Loopback59/Convector-Fan-Controller/AutoFan V4 PIC16f18424.pdf

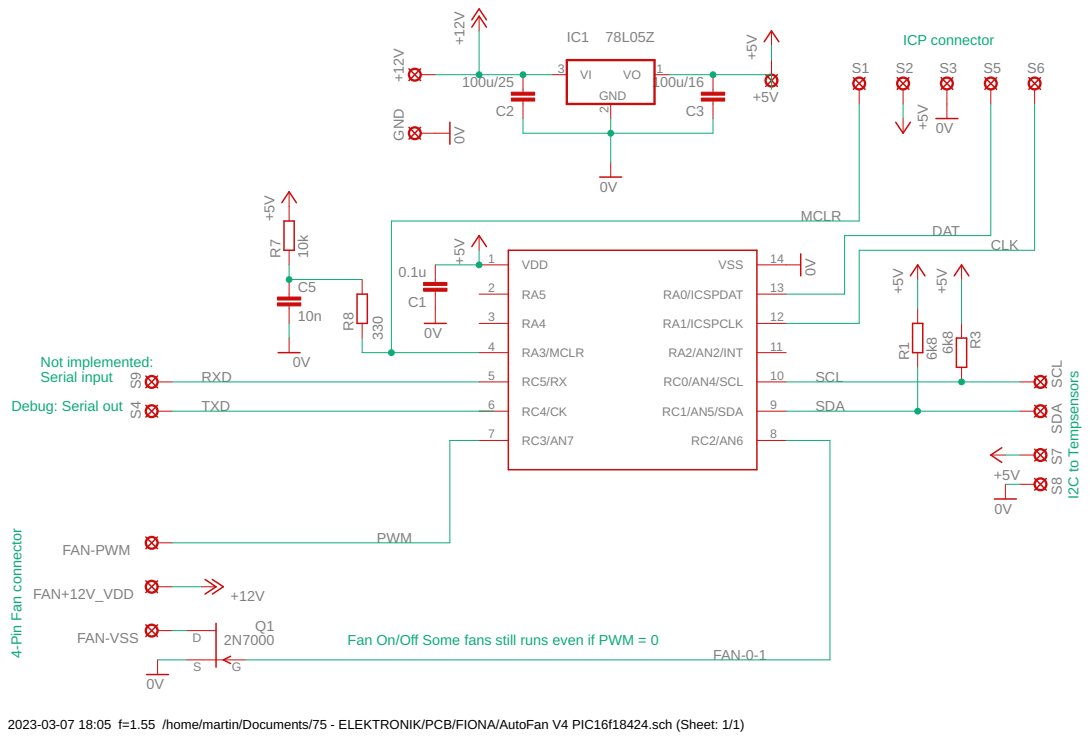
[picture p1: page 1]

Fan On/Off Some fans still runs even if PWM = 0

2023-03-07 18:05 f=1.55 /home/martin/Documents/75 - ELEKTRONIK/PCB/FIONA/AutoFan V4 PIC16f18424.sch (Sheet: 1/1)
