Loopback59/Convector-Fan-Controller/AutoFan V4 PIC16f18424.sch

## EAGLE design AutoFan V4 PIC16f18424.sch (2023-03-07)

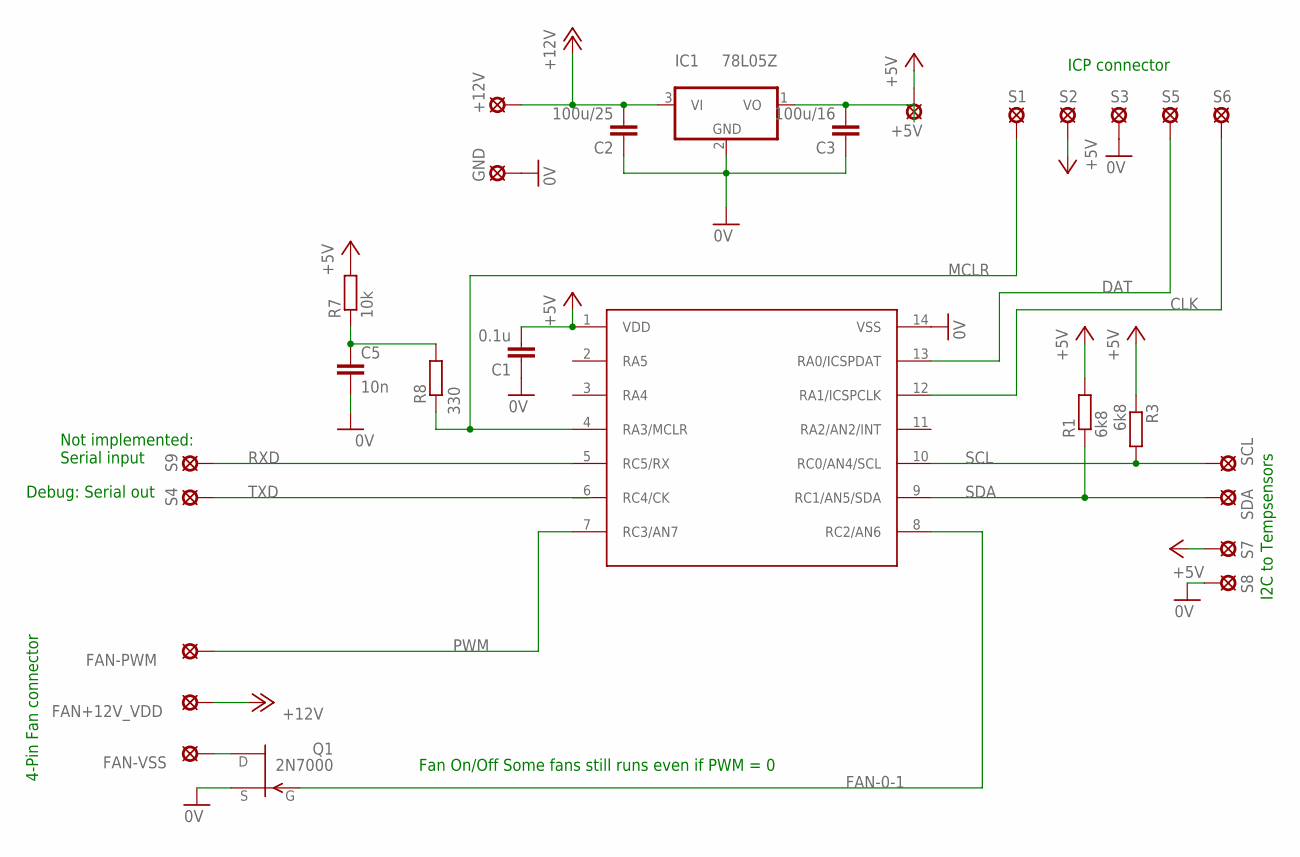
[picture p2: schematic AutoFan V4 PIC16f18424.sch]

Parts:
+5V, +12V: LSP10
C1: 0.1u; C050-024X044
C2: 100u/25; C050-024X044
C3: 100u/16; C050-024X044
C5: 10n; C050-024X044
FAN+12V_VDD: LSP10
FAN-PWM: LSP10
FAN-VSS: LSP10
GND: LSP10
IC1: 78L05Z; TO92
PIN1: PIC16F1824; DIL14
Q1: 2N7000; TO92
R1, R3: 6k8; 0207/10
R7: 10k; 0207/10
R8: 330; 0207/10
S1, S2, S3, S4, S5, S6, S7, S8, S9: LSP10
SCL: LSP10
SDA: LSP10

Connections:
0V: C1.1, C2.1, C3.1, C5.2, GND.MP, IC1.2 (GND), PIN1.14 (VSS), Q1.2 (S), S3.MP, S8.MP
+5V: +5V.MP, C1.2, PIN1.1 (VDD), R1.2, R3.1, R7.2, S2.MP, S7.MP
+12V: +12V.MP, C2.2, FAN+12V_VDD.MP, IC1.3 (VI)
CLK: PIN1.12 (RA1/ICSPCLK), S6.MP
DAT: PIN1.13 (RA0/ICSPDAT), S5.MP
FAN-0-1: PIN1.8 (RC2/AN6), Q1.3 (G)
MCLR: PIN1.4 (RA3/MCLR), R8.1, S1.MP
unnamed: C3.2, IC1.1 (VO)
unnamed: FAN-VSS.MP, Q1.1 (D)
unnamed: C5.1, R7.1, R8.2
PWM: FAN-PWM.MP, PIN1.7 (RC3/AN7)
RXD: PIN1.5 (RC5/RX), S9.MP
SCL: PIN1.10 (RC0/AN4/SCL), R3.2, SCL.MP
SDA: PIN1.9 (RC1/AN5/SDA), R1.1, SDA.MP
TXD: PIN1.6 (RC4/CK), S4.MP

Notes on the sheet:
I2C to Tempsensors
4-Pin Fan connector
ICP connector
Debug: Serial out
Fan On/Off Some fans still runs even if PWM = 0
Not implemented: Serial input
